yoonlab-bsl/RPA-Fluorescence-Detector/All 3D Printed Parts.3mf

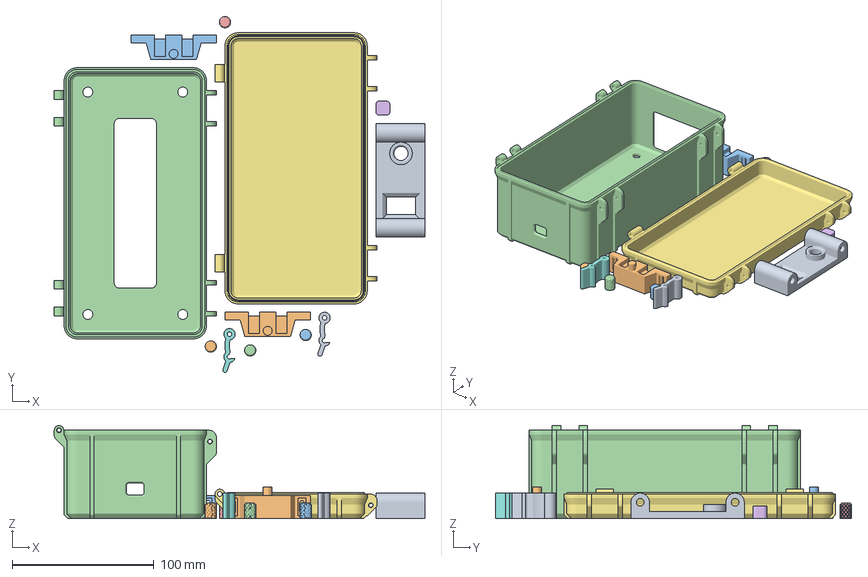
[picture p1: CAD file, 2026-11-02]
All 3D Printed Parts.3mf
261.6 x 251.3 x 65.8 mm
IO Panel
Knurled Knob M2.5 Nut
Lid Button Presser
Box - Lid
Box - Latch
Photodiode Bracket
Box - Bottom
