yoonlab-bsl/RPA-Fluorescence-Detector/(list of files, cad)

Other CAD files:
The RPA Device.f3z
