yoonlab-bsl/RPA-Fluorescence-Detector/KiCad Schematic.pdf

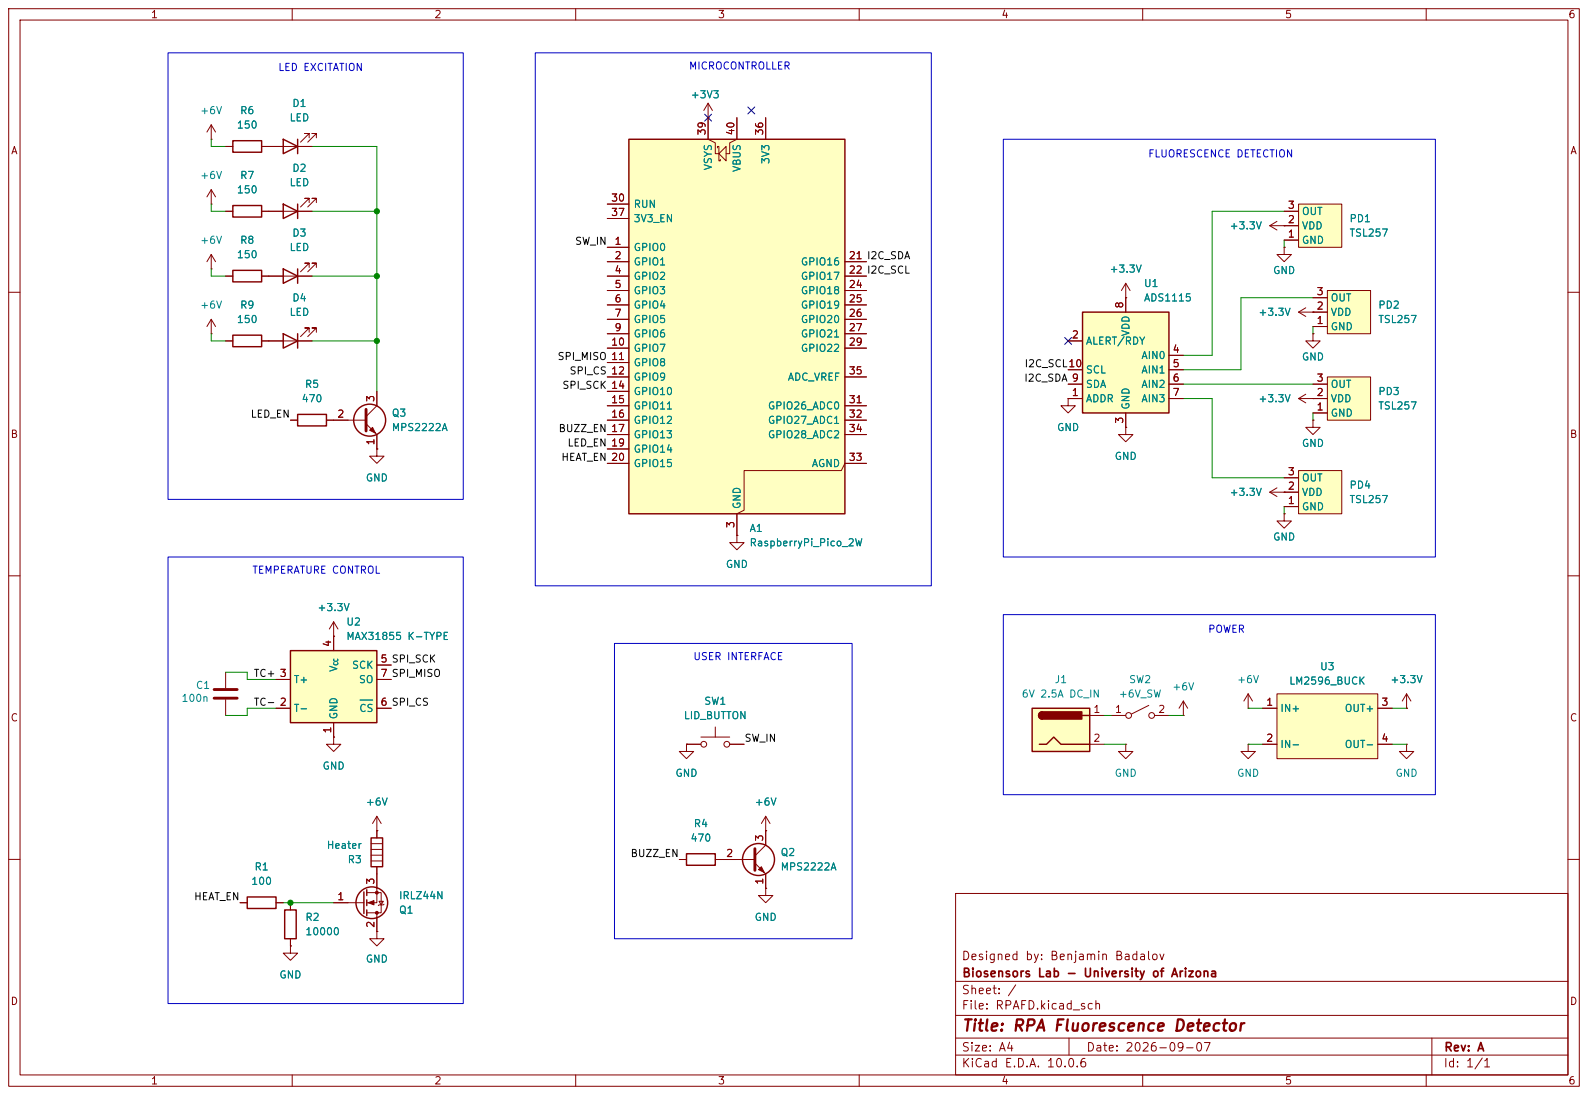
[picture p2: page 1]

Biosensors Lab - University of Arizona
Sheet: /
File: RPAFD.kicad_sch
Title: RPA Fluorescence Detector

Size: A4 | Rev: A
KiCad E.D.A. 10.0.6 | Id: 1/1
