yoonlab-bsl/RPA-Fluorescence-Detector/Heat Block Drawing.pdf

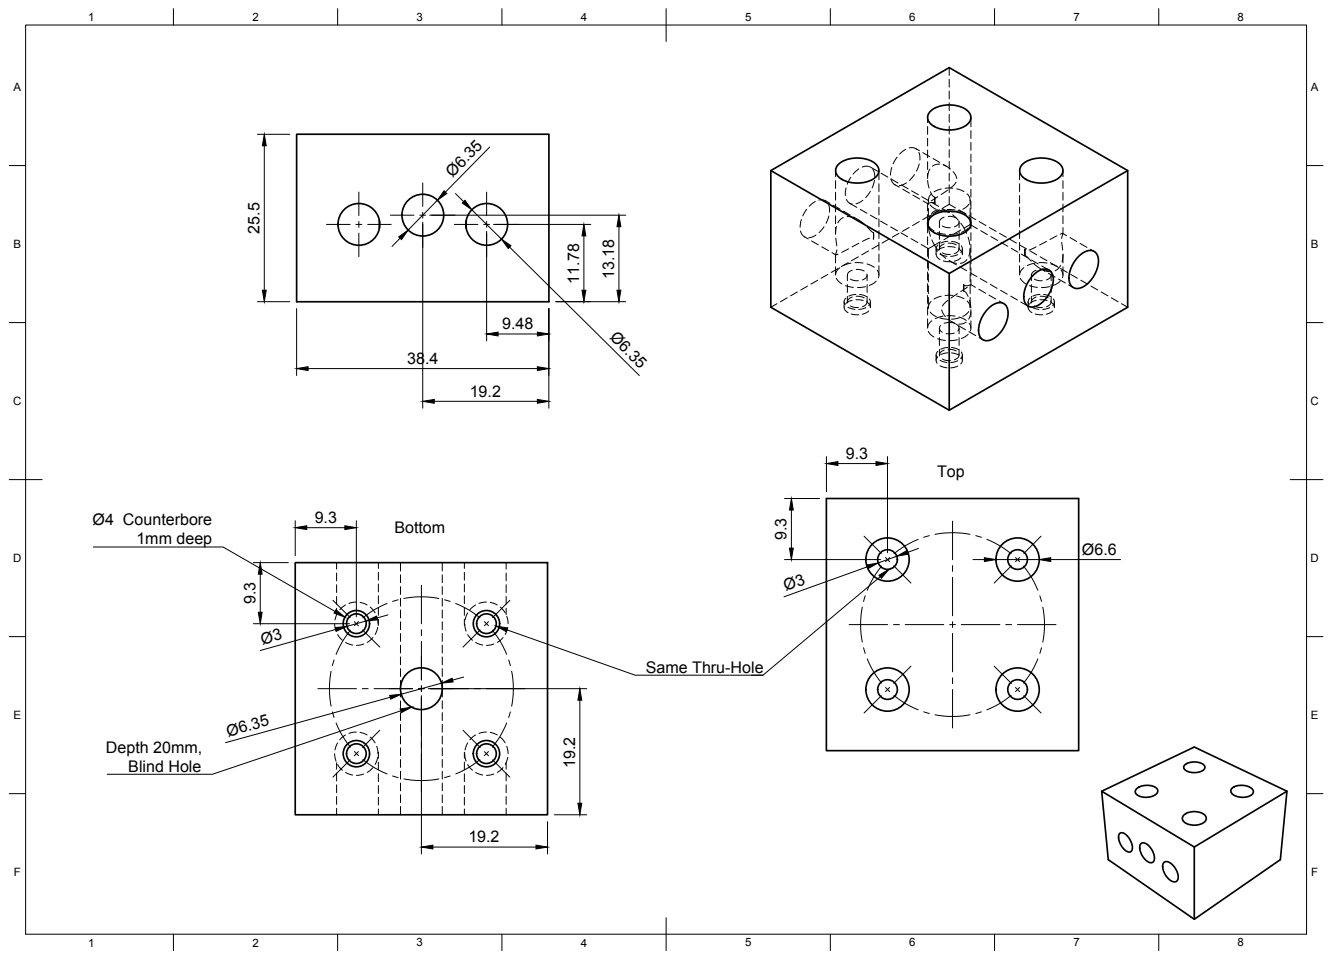
[picture p3: page 1]
Ø4 Counterbore 1mm deep; 9.3 9.3Bottom; Depth 20mm, Blind Hole

Same Thru-Hole
